Oofles/smart-meter-ics-lab/(commit log)

2026-07-07 Back up preloaded Opta firmware before PLC IDE provisioning
    DFU-dumped the factory Arduino Opta (AFX00003) image before repurposing the
    board for the lab. Internal flash (2 MB: bootloader + M7 app) is committed;
    the 16 MB QSPI image is kept local and git-ignored, with its checksum recorded.
    Image analysis: stock Finder/Arduino OPTA Modbus + WiFi example sketch, built
    with mbed_opta core 3.5.4 (build 2023-07-13), single M7 core (M4 slot empty).
    Binary image only, not recoverable source. opta/backup/README.md documents the
    flash map, the exact non-destructive dump commands, and the restore procedure.
2026-07-08 Phase 1: Opta smart-meter Modbus TCP server (Arduino sketch)
    Implement the smart-meter simulation + Modbus TCP server as an Arduino sketch
    (arduino:mbed_opta + ArduinoModbus), flashed over USB via arduino-cli. The
    Arduino PLC IDE path was abandoned: its online link crashed on Connect across
    1.0.8 / 1.1.0 / 1.0.6, as admin, on the correct (higher) Modbus COM port, and
    even with a known-good plccable sample -- a hard blocker, since the IDE only
    deploys PLC code over that link. USB flashing was 100% reliable throughout.
    - opta/smart_meter/smart_meter.ino -- meter sim: FW_MODE trip/reset, dial-driven
    VOLTAGE_X10, random-walk POWER_W, green/red lamps. Inputs read as analog +
    threshold (digit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
    [smart_meter.ino]
2026-07-08 Phase 3: SCADA-LTS on the Pi (native arm64) + Modbus data source
    Deploy SCADA-LTS via Docker Compose on the Pi 5 and poll the Opta over Modbus TCP.
    - scada/docker-compose.yml -- scadalts/scadalts:release-2.8.1 + mysql/mysql-server:8.0.32,
    both native arm64: NO emulation and NO MySQL-5.7 workaround (the old ARM64 concern is
    resolved upstream). Pi-sized heap, DB healthcheck-gated startup, named volumes.
    - scada/README.md -- deploy steps, first-login/password change, and the exact Modbus IP
    data source + 5-point config (0-based offsets matching our PDU addrs, x0.1 voltage mult).
    - CLAUDE.md -- corrected the stale ARM64 note; Phase 3 checked off.
    Verified from the bench: all 5 SCADA poin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
2026-07-08 Phase 4 (assets + steps): operator graphical view
    Add scada/assets/ (operator-bg.png panel background + optional green/red lamp PNGs) and
    the Graphical View build steps in scada/README.md: Binary graphic on POWER_STATUS
    (green/red via a built-in LED image set), Analog dial on VOLTAGE_X10, Simple points for the
    readouts. The view is assembled in the SCADA-LTS UI; scripts/mb_trip.py / mb_reset.py drive
    it for the demo.
2026-07-08 Phase 4 done: operator view; admin/admin is an intentional planted weakness
    Mark Phase 4 complete (graphical operator view: green/red indicator + voltage gauge +
    usage; attack/reset reflected live in SCADA). Re-frame the admin/admin note in CLAUDE.md and
    scada/README.md as a deliberate planted default-credential weakness for the exercise (for
    defenders to discover), not an oversight -- leave as-is unless the rig leaves the lab.
2026-07-10 Phase 5 (LoRa half): RF update listener -> FW_MODE write
    listener/ turns a malicious "firmware update" frame into a FW_MODE=1 Modbus write
    on the Opta (same trip as scripts/mb_trip.py), adding the RF layer.
    - protocol.py -- firmware-shaped 8-byte frame (SMFW|ver|type|crc16); the listener
    "validates" the CRC but the channel is unauthenticated (the lesson).
    - lora.py -- Waveshare SX1262 868M UART HAT driver: /dev/serial0 @ 9600 8N1,
    M0=BCM22/M1=BCM27 on gpiochip0 via lgpio (Pi 5). Alive-tested (config-mode read).
    - listener.py -- listen on LoRa and act; --simulate (no radio) and --send modes.
    Reuses the dependency-free scripts/mb.py, so no extra deps on the offline Pi.
    Validated: `list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
2026-07-10 Phase 5: LoRa flood mesh (drone -> propagate update to all meters)
    Replace point-to-point with an application-layer flood mesh on the existing UART
    SX1262 HATs (no Meshtastic, no new hardware) — replicates the AMI attack where a
    drone injects an update near one meter and it propagates hop-by-hop to the rest.
    - protocol.py: 11-byte frame adds msg_id (dedup) + ttl (hop limit).
    - listener.py: on RX -> dedup by msg_id, apply locally (FW_MODE=1), rebroadcast
    ttl-1 with jitter. --send is the 'drone' injection; --simulate for solo testing.
    Validated: dedup drops duplicate, bad-CRC rejected, malicious apply trips the meter.
    Full multi-hop propagation needs >=2 SX1262 nodes.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
    [listener.py, protocol.py]
2026-07-10 Phase 5: raw-SX1262 drone is a dead end — document + reverse-link diagnostic
    The Pi's Waveshare "SX1262 868M LoRa HAT" is an EBYTE E22-900T module: an SX1262
    behind an onboard MCU running proprietary, non-standard LoRa framing that only
    interoperates with other EBYTE modules. A Heltec WiFi LoRa 32 V4 (raw SX1262 +
    RadioLib) drone was tested both directions across the full SF7-12 x BW{125,250,500}
    x sync{0x12,0x34} grid -> 0 reception. Matches documented experience (RadioLib
    #1612). Frequency was verified correct (868.125 MHz), so this is a hardware-
    architecture limit, not a PHY-tuning miss.
    The RF drone must be a 2nd EBYTE/Waveshare UART HAT, not a bare SX1262.
    - drone/README.md: full w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
    [beacon.ino, rxsweep.ino, tx_beacon.py]
2026-07-11 Opta HMI redesign: operator-driven 4-light panel + SCADA panel mirror
    Reframe the Opta panel from auto-driven status lamps into an operator HMI the
    blue team configures on Day 1, and expose it to SCADA.
    Normal (FW_MODE==0): O1 blue = I1 switch, O2 green = I2 switch, O3 yellow = dial
    past 6 (of 0-10), O4 red off; POWER_STATUS=1, dial-driven voltage, usage walk.
    Attack (FW_MODE!=0, via RF payload / listener / Modbus write): O1/O2/O3 off,
    O4 red on, voltage/usage -> 0. RESET coil or I3 button clears it.
    - No local trip switch: I1 is repurposed to the blue-light switch; the fault now
    fires ONLY from FW_MODE (so a direct-Modbus attacker also trips it).
    - Panel mirror over Modbus for SCADA: di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
    [smart_meter.ino]
2026-07-11 SCADA panel mirror: provision the 6 discrete-input points via Emport
    Add the four lamp states (LAMP_BLUE/GREEN/YELLOW/RED) and two switch positions
    (SW_BLUE/SW_GREEN) to the SCADA-LTS Modbus data source as Input-status binary
    points, so the operator view mirrors the Opta's four-light panel.
    Provisioned headlessly against the live instance with scada/emport.py (drives
    SCADA-LTS's DWR-backed Emport over HTTP) and verified live: SCADA tracks the
    Opta exactly, incl. the attack override (trip -> red on, blue/green/yellow off,
    switches still reading on).
    - scada/emport.py: headless SCADA-LTS Emport export/import helper.
    - scada/emport-config.json: versioned data source + all 11 points.
    - scada/R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
2026-07-11 Add kit provisioning + replication (1 -> 45 isolated islands)
    Pi-driven, console-run provisioning so each kit provisions itself and its Opta —
    no laptop-per-kit, no SSH keys. Replication model: identical isolated islands
    (same IPs everywhere; RF is the only cross-kit link), golden SD image + a thin
    per-clone init for the unavoidable per-hardware steps.
    - provision/hat_config.py: write+verify the HAT to the golden config (ch 18 /
    868.125 MHz, air-rate 2.4k, transparent). Validated on the reference kit.
    - provision/opta_flash.sh: flash the Opta FROM the Pi via dfu-util + a prebuilt
    .bin (1200-baud touch -> DFU -> 0x08040000). No Arduino toolchain on the Pi.
    - provision/kit_init.sh: per-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
2026-07-11 Provisioning: per-kit IP scheme + baked-in SSH management
    - provision.sh now takes a <kit-number>: sets the Pi's wired IP to
    192.168.1.(100+kit) (kit 9 -> .109). Opta stays .210 on every kit (single
    firmware; each Pi talks to its own Opta), so don't bridge the OT switches.
    - New `ssh` phase: enables sshd + installs provision/authorized_keys on every
    kit, so any kit is reachable from a management laptop. Deliberate for the
    isolated lab (same spirit as the planted admin/admin cred).
    - kit_init.sh <kit>: thin per-clone wrapper (net ssh hw verify).
    - provision/authorized_keys: version-controlled management public keys.
    - PROVISION.md + CLAUDE.md updated for the addressing + SSH model.
    C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
2026-07-11 Per-kit Opta IPs (.200+kit) via a patchable firmware marker
    The Opta IP is compiled in, and the prebuilt .bin didn't store it contiguously
    (can't blind-patch). So the sketch now embeds a locatable, non-foldable
    `KITCFGv1` marker + IP octets; provision/patch_ip.py rewrites the host octet in
    a copy of the .bin at flash time. One prebuilt firmware still serves every kit —
    no per-kit recompile.
    - opta/smart_meter: KIT_NETCFG marker (volatile const), IP built from it in setup.
    - provision/patch_ip.py: stamp the octet; opta_flash.sh <octet> patches then flashes.
    - provision.sh: kit N -> Opta 192.168.1.(200+N); SCADA data-source host and the
    listener --host are pointed at it, verify reads it.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
    [patch_ip.py, smart_meter.ino]
2026-07-11 provision: don't let the OT switch steal the default route
    phase_net set ipv4.gateway=192.168.1.1 on eth0, but the exercise switch is an
    isolated island with no router at .1. NetworkManager still installed a default
    route via eth0 (metric 100) that outranked WiFi (metric 600), so DNS and docker
    pulls went out the dead switch link and timed out — this failed the SCADA image
    pull mid-build on kit 9.
    Fix: no gateway on eth0 + ipv4.never-default, so eth0 never installs a default
    route and WiFi stays the only path to the internet during setup. Verified
    persistent on kit 9 (trixie): NM wrote never-default/no-gateway back to netplan.
2026-07-11 listener/HAT: use /dev/ttyAMA0, not /dev/serial0 (trixie serial0 = Bluetooth)
    The HAT lives on the GPIO14/15 header UART. On Raspberry Pi OS Bookworm serial0
    symlinks to ttyAMA0 (the RP1 header UART), so hardcoding /dev/serial0 worked. But
    on Debian 13 (trixie) serial0 -> ttyAMA10, which is the *Bluetooth* SoC UART — every
    write went to nothing and the module was silent. ttyAMA0 is the header UART on both
    OSes, so address it directly in lora.py + hat_config.py (and report the real port in
    listener.py). Diagnosed on kit 9 (trixie) via the dmesg UART MMIO map (ttyAMA0 =
    1f00030000 RP1 vs ttyAMA10 = 107d001000 SoC, hci_uart_bcm bound to serial0) plus a
    config-mode probe that read golden off a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
2026-07-11 attack modes: TEST (resettable) vs EXERCISE LOCK (persistent, RESET disabled)
    Adds a second attack mode so a facilitator can run either a resettable demo trip or
    a "stuck" fault the blue team can't reset away.
    Contract (docs/register-map.md): FW_MODE gains value 2.
    0 = normal
    1 = malicious TEST — operator RESET (coil 15 / I3) clears it (unchanged behavior)
    2 = malicious LOCK — RESET is IGNORED; persists across an Opta power-cycle; cleared
    only by a direct FW_MODE:=0 write (facilitator "re-flash")
    Opta (smart_meter.ino): RESET clears fw==1 only; a lock flag is persisted to Opta flash
    via Arduino_KVStore (written on transitions), restored in setup() so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
    [listener.py, protocol.py, smart_meter.ino]
2026-07-11 attack modes: drop KVStore persistence (hard-faults the Opta) — RAM-only for now
    Arduino_KVStore.begin() hard-faults the Opta at boot on this H7 (mbed_die / red
    fault-blink; its QSPI KVStore partition isn't provisioned), which bricked kit 9's
    Opta until a double-tap-reset + reflash. Remove KVStore entirely and rebuild the
    firmware .bin.
    The two attack modes are unchanged and intact: FW_MODE=1 TEST (operator RESET
    clears) vs FW_MODE=2 EXERCISE LOCK (operator RESET coil/I3 IGNORED; cleared only by
    a direct FW_MODE:=0 write / mb_unlock.py). The LOCK is now RAM-only, so an Opta
    power-cycle also clears it — flash-persistence across reboots is deferred to a
    bench-tested follow-up (reserved in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
    [listener.py, smart_meter.ino]
2026-07-11 listener: fix LOCK apply log wording (RAM-only, not 'survives reboot')
    [listener.py]
2026-07-11 central: fleet-status collector + beacons — the facilitator's fleet console
    Adds the reverse (telemetry) direction so the central node can see every kit.
    - protocol.py: new SMST status frame (kit_id + FW_MODE), distinct magic so field
    kits scanning for SMFW ignore each other's beacons — only the collector parses them.
    - listener.py: each field kit now beacons its status on a ~20s heartbeat AND on state
    change, ttl=1 (direct only). Kit id auto-derived from --host (Opta .20N -> N) or --kit.
    RX loop now resyncs on the SMFW magic so beacons/garbage can't misalign the parser.
    - central/collector.py: central-node service — listens for beacons (+ optional RSSI),
    applies attack frames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
    [listener.py, protocol.py]
2026-07-11 docs: note Opta Modbus server wedges on eth0 link bounce (reboot to clear)
    Blocking single-client ArduinoModbus TCP server + no keepalive: a Pi IP
    change / replug leaves a no-FIN dead client that jams the server (new
    clients get RST). Hit it moving the central Pi .11->.100. Reboot the Opta
    to recover; non-blocking server is a firmware follow-up.
2026-07-12 Descope SCADA; switch replication to per-kit build
    The blue team's operator view is the Opta's physical 4-light panel — no
    software HMI. Remove SCADA-LTS entirely (deletes scada/, drops Docker from
    provision.sh, removes phase_scada + the scada phase). This also drops the
    whole ARM64-image concern and the slowest per-kit step.
    Replication is now per-kit, not golden-image cloning: on each kit, git clone
    and run `provision.sh <N>`. This stamps the correct per-kit Opta IP into each
    kit's listener service (the clone path would have baked kit 9's .209 into all
    44 clones' units) and sidesteps shared-host-key / shared-machine-id hazards.
    Delete the now-obsolete kit_init.sh clone helper.
    Docs upd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
2026-07-12 RF console: broadcast trip/reset from Kit 00 + reset-over-LoRa frame
    Kit 00 is now the drone/injection node too. The collector transmits over the
    same HAT it listens on (shared via a lock), so the facilitator can broadcast
    to all in-range kits without stopping the service:
    - protocol: new TYPE_RESET (0x03) — facilitator recovery over RF (FW_MODE:=0,
    clears TEST *and* LOCK). Old firmware ignores unknown types as a no-op, safe to mix.
    - listener: apply reset; `--send reset` / `--simulate reset`.
    - collector: POST /api/send {type,ttl} builds+broadcasts a frame and applies it
    to Kit 00's own Opta; thread-safe HAT access (RX read vs. TX).
    - dashboard: RF Console card — Trip all (TEST/LOC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
    [listener.py, protocol.py]
2026-07-15 drone: provision/drone.sh — reproducible RF injection node build
    Builds a Pi as the attacker/drone: HAT on GOLDEN, SSH keys, UART on, but NO
    Opta flash and NO listener service (it injects on demand). Also converts a Pi
    previously built as a field kit (disables the leftover smartmeter-listener).
    Phased like provision.sh; optional octet sets the wired IP. Backup drone (Pi
    Zero) builds identically. Doc: PROVISION.md "The drone", drone/README.md.
2026-07-15 drone: data-mule — carry out-of-range kit status back to Kit 00
    scripts/datamule.py: roaming drone buffers field kits' SMST beacons and re-emits
    them (version=2 = relayed) so a kit outside the central collector's range still
    shows on the fleet dashboard once the drone passes back in range. STATUS only
    (store-and-forward), first-hand beacons only (no mule-to-mule loops), entries
    expire if not re-heard.
    protocol.py: reserve SMST version 2 for relayed beacons (backward-compatible;
    kits still send v1). collector.py: record relayed beacons with rssi=None and a
    `relayed` flag; a directly-heard beacon always wins over a muled copy. fleet.html:
    show muled kits as "via mule" (no bogus direct-RSSI)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
2026-07-15 drone: autonomous boot-armed payload service + launch countdown
    listener.py --start-delay N: visible pre-launch countdown before the first
    injection. provision/drone_service.sh: installs smartmeter-drone.service (runs
    listener.py --send --loop on boot) + /etc/default/smartmeter-drone config
    (payload/ttl/interval/delay; one line swaps TEST -> EXERCISE LOCK). Installed
    DISABLED so bench boots are inert; `systemctl enable` is the deliberate arm for
    the field, then power-on-and-throw. Conflicts= the mesh listener (shared HAT).
    Validated on the .140 drone: benign run showed the 6s countdown -> looped
    injects at the configured ttl/interval; config restored to malicious/TEST
    defaults; service left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
    [listener.py]
2026-07-15 drone: default DRONE_TTL=3 (flood the mesh on one flyby)
    Bake ttl 3 as the built-in default in the drone payload config so every drone
    build (incl. the Pi Zero backup) propagates via relays out of the box; drop to 1
    for direct-range-only. Docs table updated to match.
2026-07-16 provision: kit_915_update.sh — push the 915 re-channel to one built kit over SSH
    Facilitator-side helper for rolling the ch18->ch65 (868->915) HAT change out
    to the ~12 already-built kits. Each kit is on its own isolated switch with no
    internet, so this does NOT git pull on the kit: it scp's this laptop's committed
    provision/hat_config.py to the kit and runs it there, writing 915.125 MHz into
    the HAT NVM (persistent; no reboot needed).
    Run from the laptop once per kit, connected to that kit's switch:
    provision/kit_915_update.sh <N> # write + verify
    provision/kit_915_update.sh <N> read # just read current config
    Handles the serial contention (stops smartmeter-listener / -coll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
2026-07-18 demo: isolated DV walk-through mesh (Kits 43-45, ch 58 / 908.125 MHz)
    A separate 3-kit demo of the RF attack for DV tours, on its own LoRa mesh so
    payloads can't reach the live exercise fleet (ch 65 / 915.125 MHz). Isolation
    is by channel = RF centre frequency: a radio only demodulates its own channel,
    so ch 58 (908.125 MHz) is fully PHY-isolated from ch 65. Payload frames are
    unchanged, so the demo stays faithful to the real attack.
    - hat_config.py: add --channel N (default stays GOLDEN ch 65; ch-65 bytes
    identical to before, 0x41 literal preserved for kit_915_update.sh's guard).
    Moved serial/lgpio imports into main() so the config math is importable/testable.
    - provision.sh: HAT_CHANN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
2026-07-18 demo.html: attack-path console redesign + dark default
    Rework the DV demo dashboard for a 3-kit build so it fills the screen and reads
    well across a room: injector (K43) as an elevated center hub with animated LoRa
    links radiating to the two victim meters (links glow red when a victim faults),
    big glowing 4-lamp panels, per-node status banners and readouts. Dark mode is now
    the default (data-theme="dark" on <html>; toggle still flips to light). Stage
    skeleton builds once and updates in place so the RF-link animation doesn't restart;
    delivering a payload briefly speeds up the pulses. Served-from-disk, so a git pull
    on the central updates it with no collector restart.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
2026-07-21 central: USB 4-key macropad -> facilitator RF trigger (Kit 00)
    Optional physical shortcut for the dashboard send button. keypad.py reads a
    plugged-in macropad via evdev and, per keypress, POSTs to the local collector's
    /api/send -- so it reuses the collector's radio (no /dev/ttyAMA0 contention) and
    does exactly what clicking send in fleet.html does: broadcast over LoRa + trip
    Kit 00's own Opta.
    - keypad.py: --learn auto-discovers device + keycode (watches all input devices);
    runtime grabs the pad exclusively, per-action cooldown, POST failures non-fatal.
    - smartmeter-keypad.service + provision/keypad_service.sh (deps, input group, unit).
    - docs: central/README.md section + CLAUDE.md point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
2026-07-22 scripts: kit_fieldcheck.sh + field card — on-site hop-2 confirm + WiFi harden
    Deployed kits are islanded; a beacon only proves hop 1 (RF+Pi alive). Hop 2 —
    the Pi reaching its own Opta over the local wired link to write FW_MODE — is
    invisible remotely and fails silently if eth0's IP is wrong or the Opta wedged.
    kit_fieldcheck.sh (run on the kit's Pi via SSH from a laptop on its switch):
    checks eth0 static IP, that the Opta route egresses eth0 (flags wlan0 dual-homed
    on 192.168.1.x), proves hop 2 via mb_read from the Pi, optional --trip panel
    test (trip+reset), optional --wifi-off / --forget-wifi isolation harden. Prints
    GO/NO-GO. docs/kit-fieldcheck-card.md is the red-team quick refer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
2026-07-23 docs: BOM.md — full bill of materials + substitution notes
    Answers the 'how do I build my own kit' questions: per-kit parts table
    (trainer kit, Pi 5, Waveshare SX1262 HAT, switch, cables), central-node
    and drone additions, and an alternatives section (any mini PC works via
    the HAT's USB mode; the EBYTE-family radio is the one non-substitutable
    part). Linked from README.
    Claude-Session: https://claude.ai/code/session_01B9dC2Vqq2pUCBeiJCSmyvm
2026-07-23 README: realign the data-flow diagram
    The old ASCII layout had the Modbus arrow landing in space and the
    beacon line hanging off the Opta box. Redraw as two parallel columns:
    drone -> listener -> Opta, with the listener's status beacons feeding
    Kit 00 and the Opta driving the light panel.
    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
